scespedesa/Cutting-marble-machine/(list of files, cad)

Other CAD files:
Cableados_PackandGo/Tablero_Electrico_MotorHusillo/1.ipt
Cableados_PackandGo/Tablero_Electrico_MotorHusillo/2.ipt
Cableados_PackandGo/Tablero_Electrico_MotorHusillo/3.ipt
Cableados_PackandGo/Tablero_Electrico_MotorHusillo/4.ipt
Cableados_PackandGo/Tablero_Electrico_MotorHusillo/5.ipt
Cableados_PackandGo/Tablero_Electrico_MotorHusillo/6.ipt
Cableados_PackandGo/Tablero_Electrico_MotorHusillo/Bornera_Linea.iam
Cableados_PackandGo/Tablero_Electrico_MotorHusillo/Bornera_Tierra.iam
Cableados_PackandGo/Tablero_Electrico_MotorHusillo/Breaker.iam
Cableados_PackandGo/Tablero_Electrico_MotorHusillo/CLIP.ipt
Cableados_PackandGo/Tablero_Electrico_MotorHusillo/COQUE.ipt
Cableados_PackandGo/Tablero_Electrico_MotorHusillo/ECX1050.ipt
Cableados_PackandGo/Tablero_Electrico_MotorHusillo/GCX1231L OPERATOR.ipt
Cableados_PackandGo/Tablero_Electrico_MotorHusillo/GCX1232L OPERATOR.ipt
Cableados_PackandGo/Tablero_Electrico_MotorHusillo/GCX1234L OPERATOR.ipt
Cableados_PackandGo/Tablero_Electrico_MotorHusillo/GUARDAMOTOR_TUERCA.ipt
Cableados_PackandGo/Tablero_Electrico_MotorHusillo/LED_Rojo.iam
Cableados_PackandGo/Tablero_Electrico_MotorHusillo/LED_Verde.iam
Cableados_PackandGo/Tablero_Electrico_MotorHusillo/Led_Azul.iam
Cableados_PackandGo/Tablero_Electrico_MotorHusillo/MANETTE.ipt
Cableados_PackandGo/Tablero_Electrico_MotorHusillo/RTO_8-TC_BU-select.ipt
Cableados_PackandGo/Tablero_Electrico_MotorHusillo/Riel1.ipt
Cableados_PackandGo/Tablero_Electrico_MotorHusillo/Riel_Din_100.ipt
Cableados_PackandGo/Tablero_Electrico_MotorHusillo/Tablero_RocaHusillo.Harness1.iam
Cableados_PackandGo/Tablero_Electrico_MotorHusillo/Tablero_RocaHusillo.Harness1.ipt
Cableados_PackandGo/Tablero_Electrico_MotorHusillo/Temporizador.ipt
Cableados_PackandGo/Tablero_Electrico_MotorHusillo/UK_35-PE_N-select.ipt
Cableados_PackandGo/Tablero_Electrico_MotorHusillo/VIS_7D.ipt
Cableados_PackandGo/Tablero_Electrico_MotorHusillo/cajamotorhusilllo.idw
Cableados_PackandGo/Tablero_Electrico_MotorHusillo/contactor.ipt
Cableados_PackandGo/Tablero_Electrico_MotorHusillo/ecx1029.ipt
Cableados_PackandGo/Tablero_Electrico_MotorHusillo/reletermico.iam
PlanosTablerosElectricosyCajareductoratorque/Aumentador.ipn
PlanosTablerosElectricosyCajareductoratorque/PlanosTablerosElectricosyCajareductoratorque/Aumentador.ipn
