scespedesa/Cutting-marble-machine/PDF_PLANOS/DibujoMesaEnsamblada.pdf

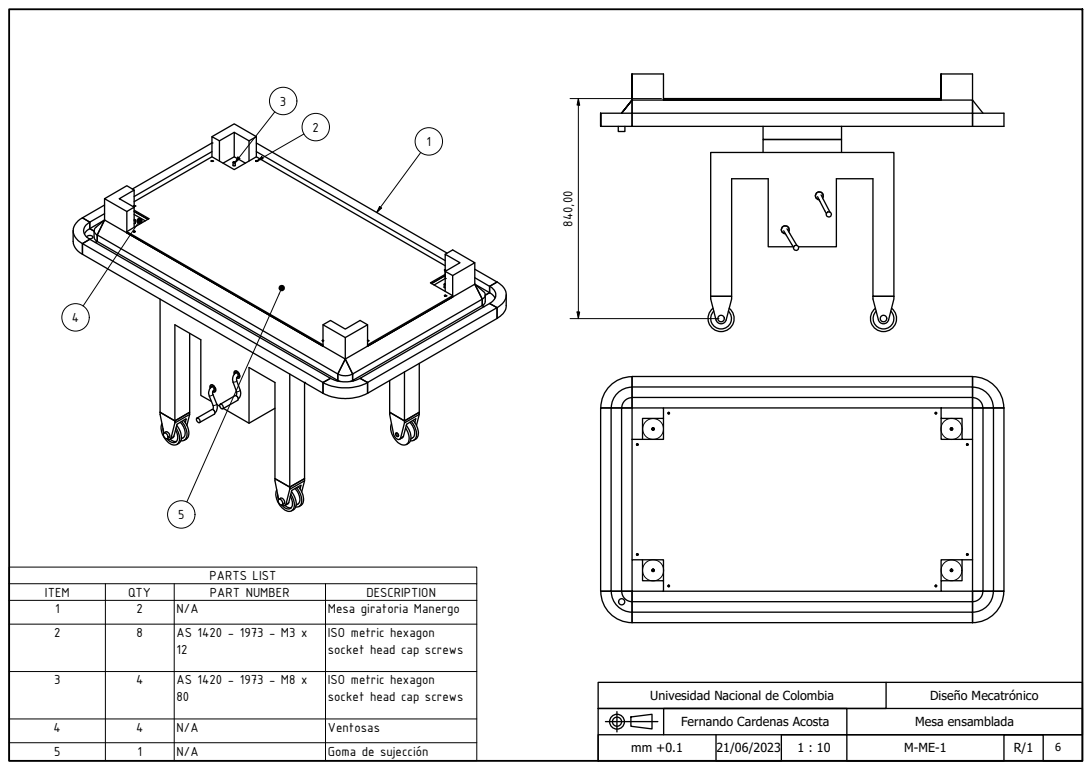
[picture p1: page 1]
PARTS LIST

ITEM | QTY | PART NUMBER | DESCRIPTION
1 | 2 | N/A | Mesa giratoria Manergo

2 | 8 | AS 1420 - 1973 - M3 x 12 | ISO metric hexagon socket head cap screws

3 | 4 | AS 1420 - 1973 - M8 x 80 | ISO metric hexagon socket head cap screws

Univesidad Nacional de Colombia | Diseño Mecatrónico

4 | 4 | N/A | Ventosas

Fernando Cardenas Acosta Mesa ensamblada

5 | 1 | N/A | Goma de sujección
