scespedesa/Cutting-marble-machine/PDF_PLANOS/Cabezal.pdf

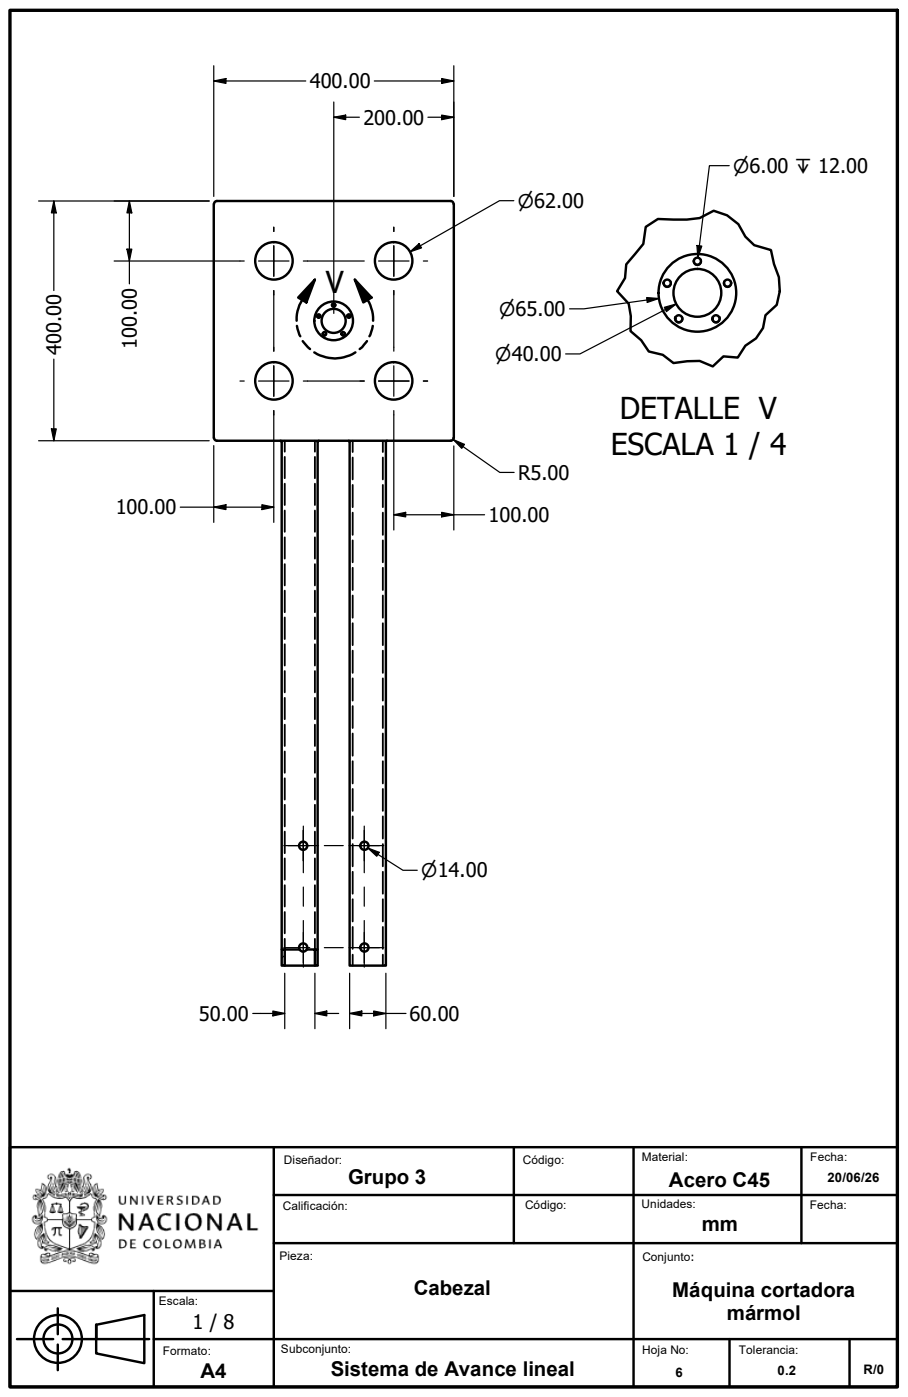
[picture p2: page 1]
DETALLE V ESCALA 1 / 4

Disexador: Grupo 3 | Cydigo: | Material: Acero C45 | Fecha: 20/06/26

Calificaciyn: | Cydigo: | Unidades: mm | Fecha:

Pieza: Cabezal | | Conjunto: Miquina cortadora mirmol

Escala: 1 / 8

Forma A4 | Subconjunto: to: Sistema de Avance lineal | Hoja No: 6 | Tolerancia: 0.2 | R/0
