scespedesa/Cutting-marble-machine/PDF_PLANOS/Copia de PlanoCajaReductorTorque.pdf

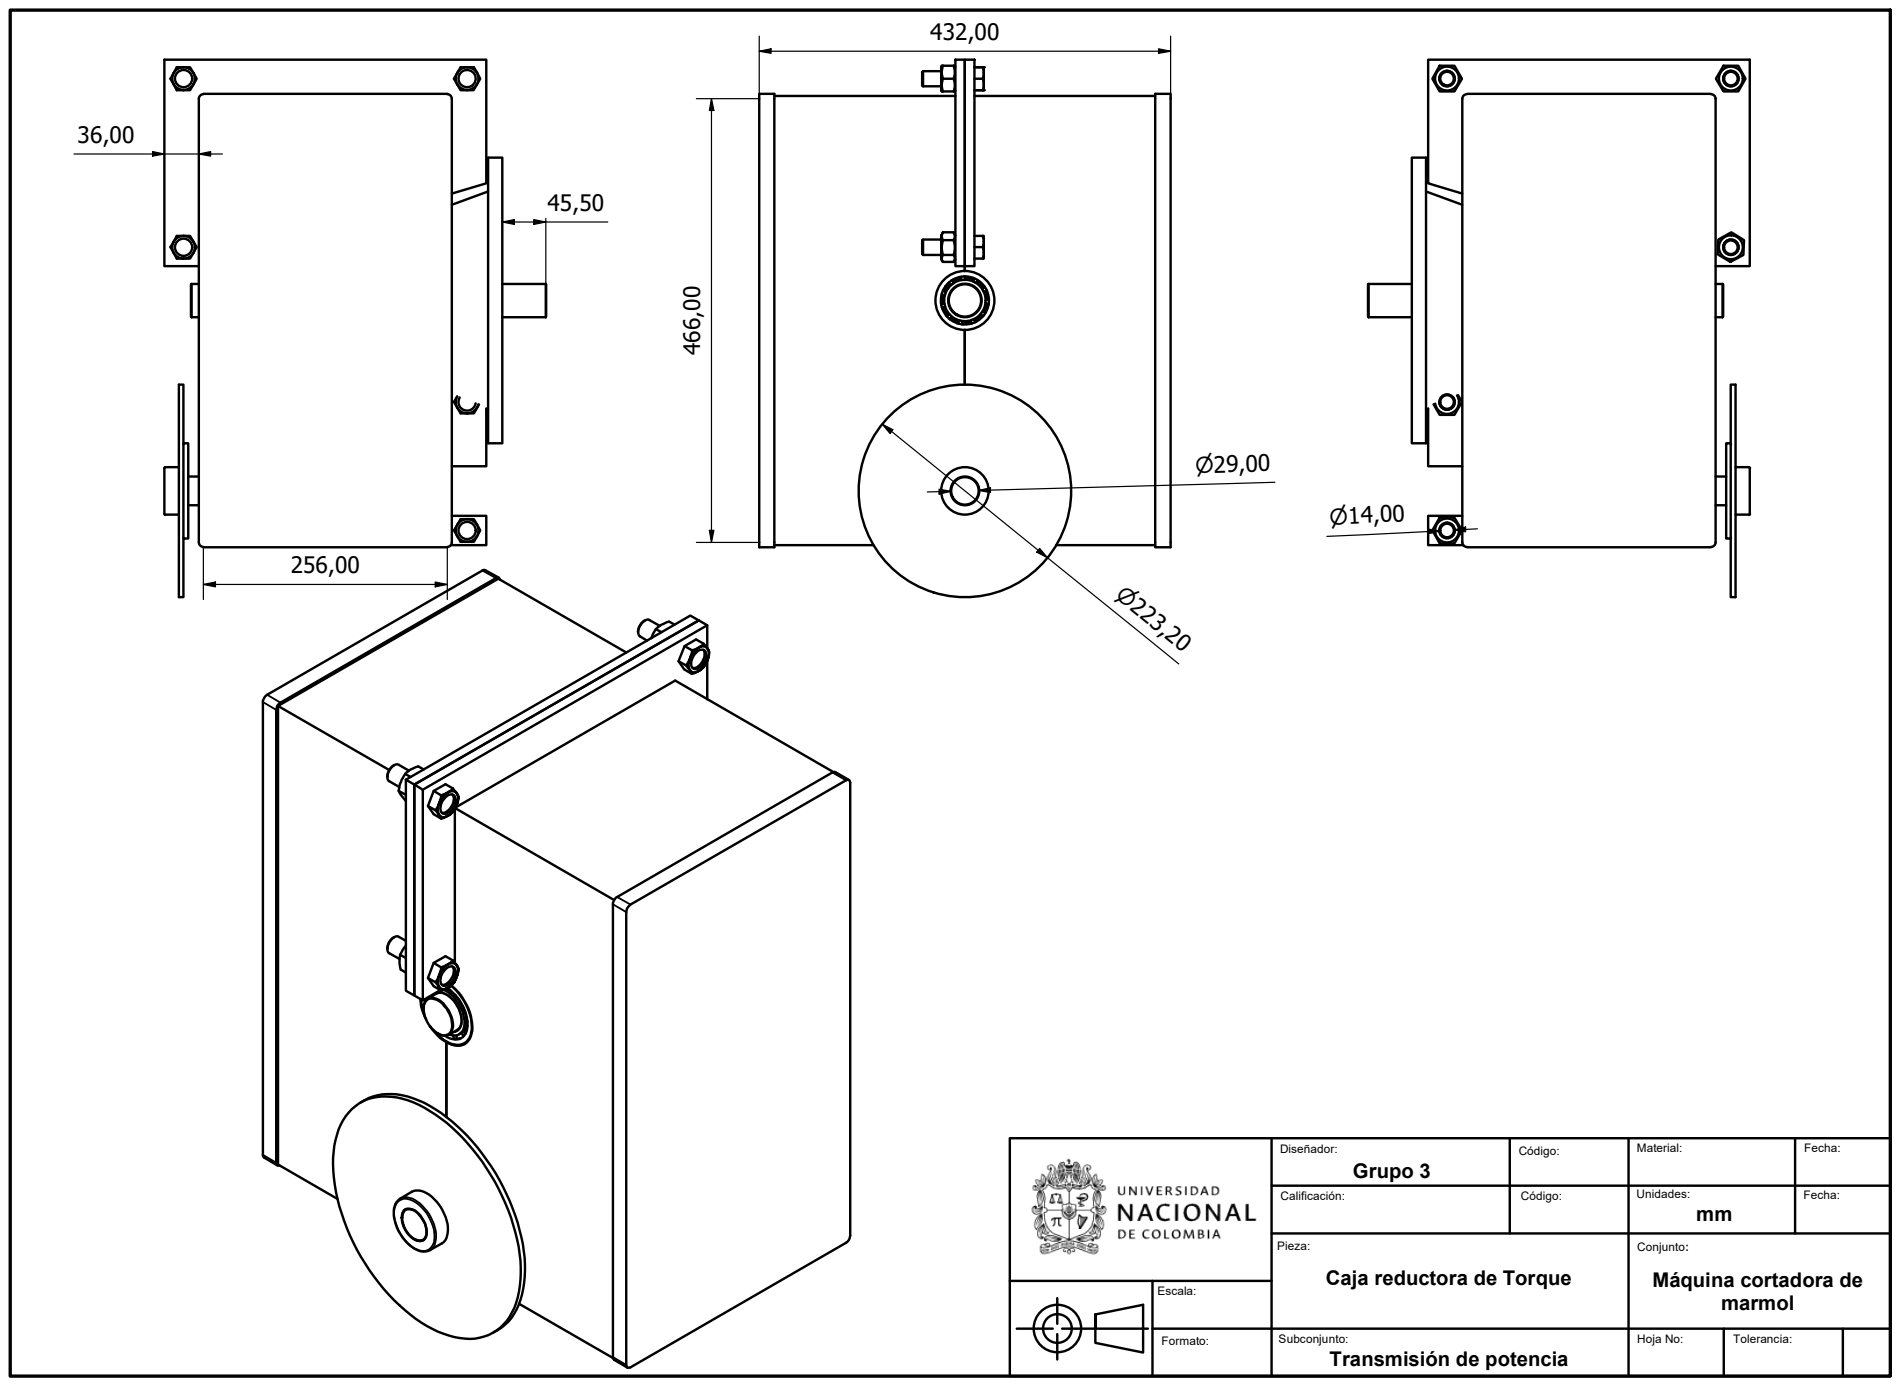
[picture p3: page 1]

Diseñador: Grupo 3 | Código: | Material: | Fecha:

Calificación: | Código: | Unidades: mm | Fecha:

Pieza: Caja reductora de Torque | | Conjunto: Máquina cortadora de marmol

Escala:

Forma | Subconjunto: to: Transmisión de potencia | Hoja No: | Tolerancia:
