scespedesa/Cutting-marble-machine/PDF_PLANOS/Parales.pdf

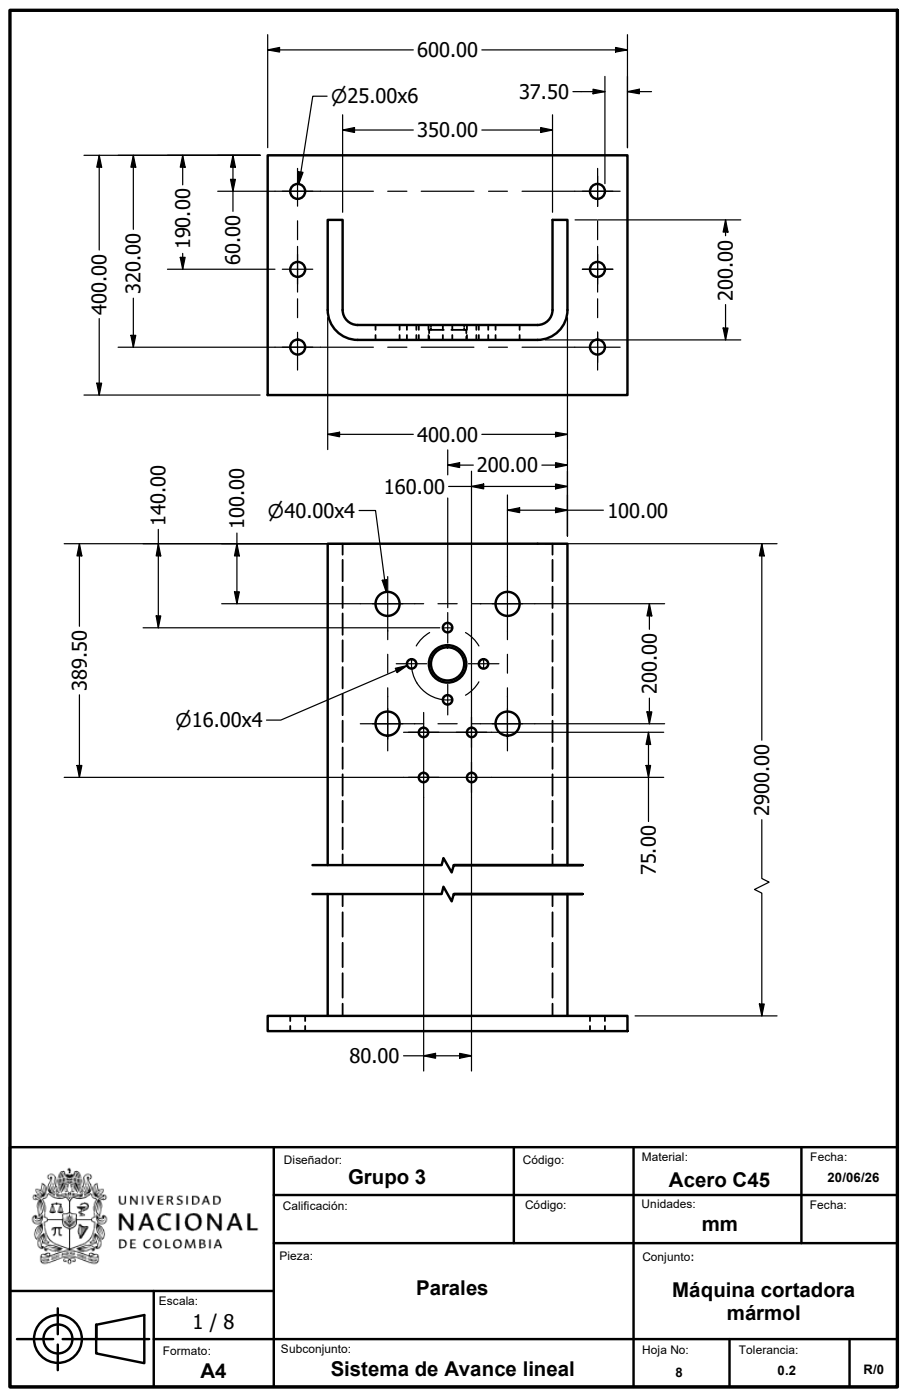
[picture p4: page 1]

Disexador: Grupo 3 | Cydigo: | Material: Acero C45 | Fecha: 20/06/26

Calificaciyn: | Cydigo: | Unidades: mm | Fecha:

Pieza: Parales | | Conjunto: Miquina cortadora mirmol

Escala: 1 / 8

Forma A4 | Subconjunto: to: Sistema de Avance lineal | Hoja No: 8 | Tolerancia: 0.2 | R/0
