scespedesa/Cutting-marble-machine/PDF_PLANOS/Plano_Eje_Proyecto_Final.pdf

40.00

60.00 | 100.00 | 100.00

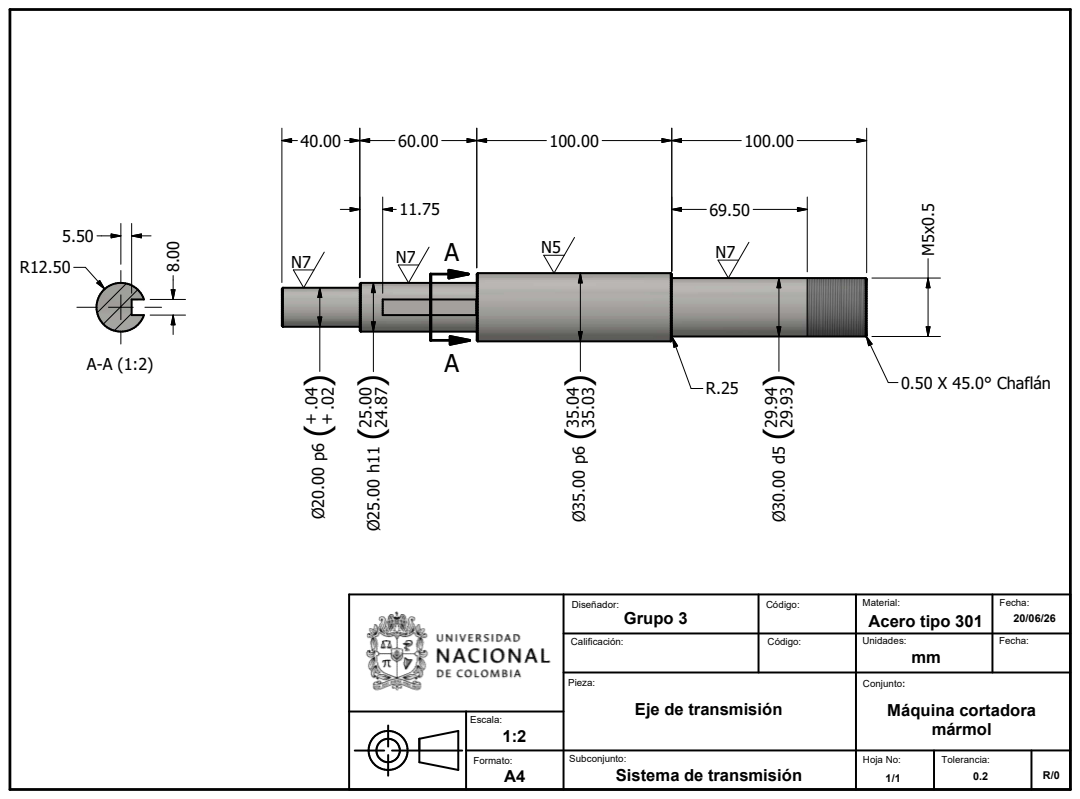
[picture p5: page 1]
M⁵x0.5; 0.50 X 45.0° Chaflán

Diseñador: Grupo 3 | Código: | Material: Acero tipo 301 | Fecha: 20/06/26

Calificación: | Código: | Unidades: mm | Fecha:

Pieza: Eje de transmisión | | Conjunto: Máquina cortadora mármol

Escala: 1:2

Formato: A4 | Subconjunto: Sistema de transmisión | Hoja No: 1/1 | Tolerancia: 0.2 | R/0
