scespedesa/Cutting-marble-machine/PDF_PLANOS/Soporte Motor.pdf

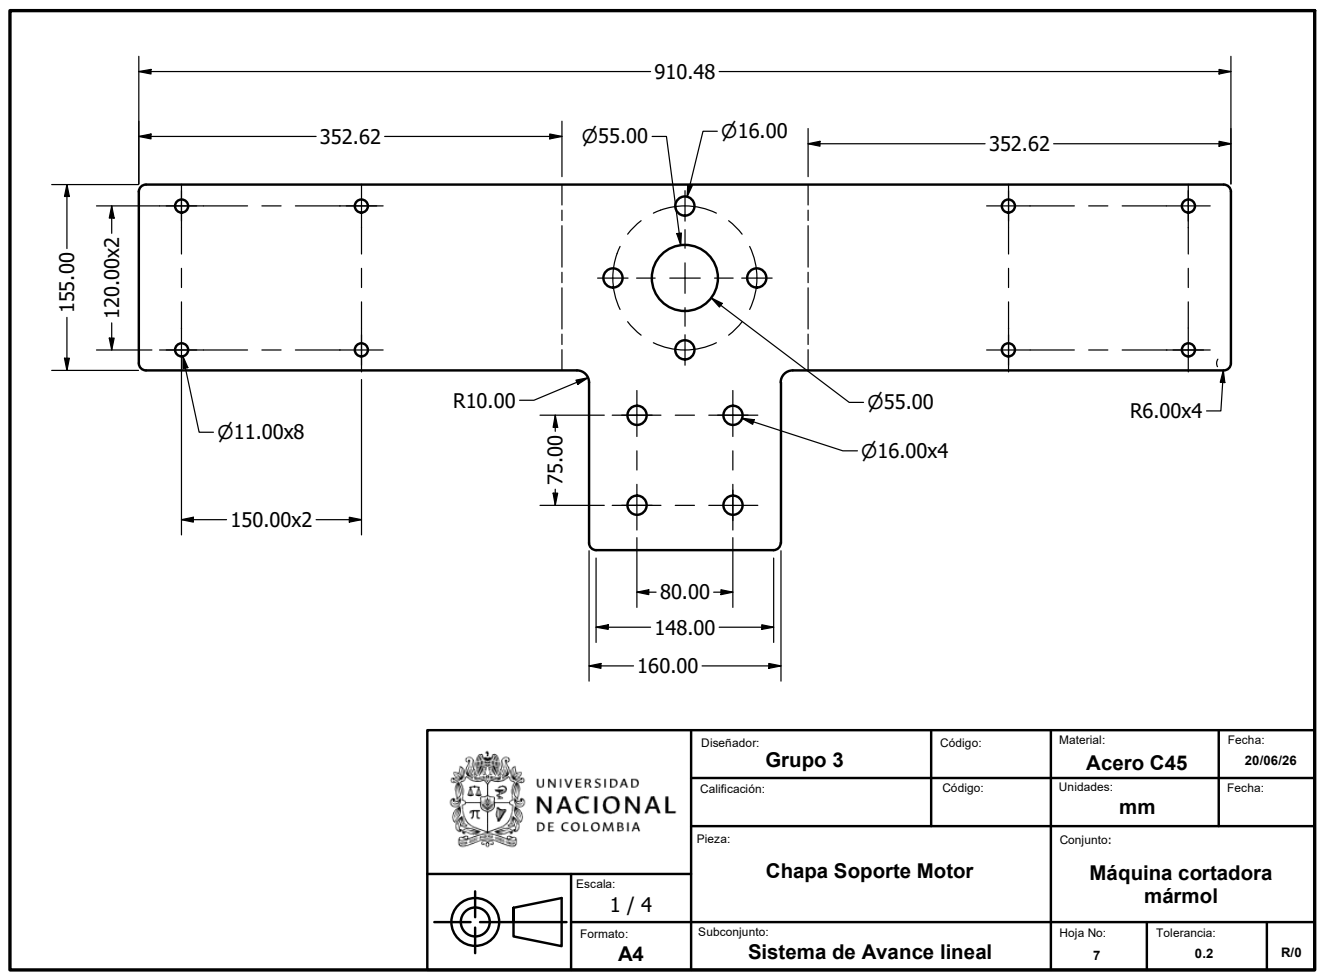
[picture p6: page 1]

Disexador: Grupo 3 | Cydigo: | Material: Acero C45 | Fecha: 20/06/26

Calificaciyn: | Cydigo: | Unidades: mm | Fecha:

Pieza: Chapa Soporte Motor | | Conjunto: Miquina cortadora mirmol

Escala: 1 / 4

Forma A4 | Subconjunto: to: Sistema de Avance lineal | Hoja No: 7 | Tolerancia: 0.2 | R/0
