scespedesa/Cutting-marble-machine/PDF_PLANOS/Tornillo de potencia.pdf

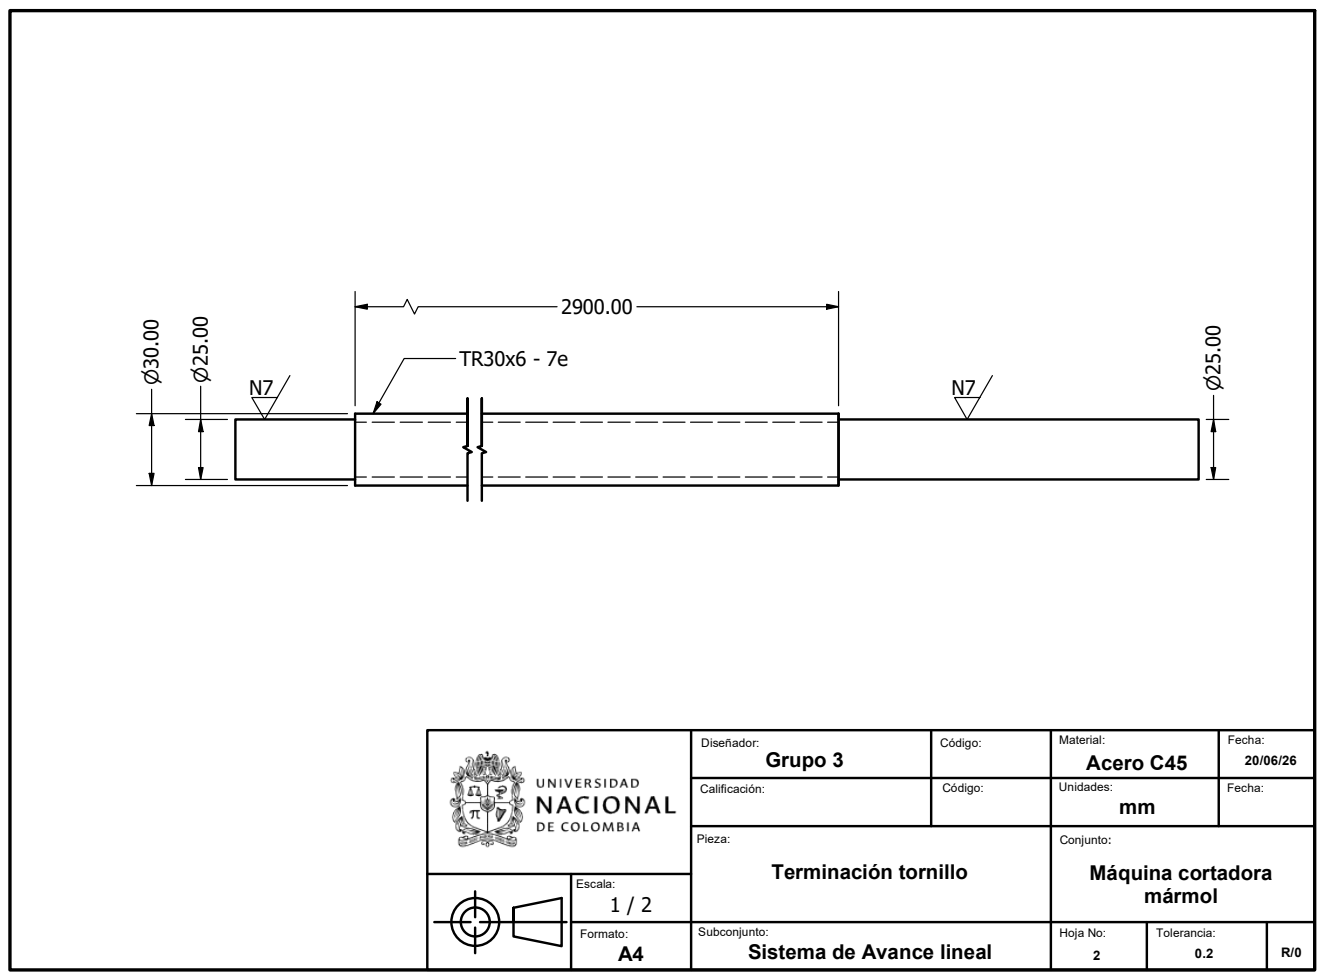
[picture p7: page 1]

Disexador: Grupo 3 | Cydigo: | Material: Acero C45 | Fecha: 20/06/26

Calificaciyn: | Cydigo: | Unidades: mm | Fecha:

Pieza: Terminaciyn tornillo | | Conjunto: Miquina cortadora mirmol

Escala: 1 / 2

Forma A4 | Subconjunto: to: Sistema de Avance lineal | Hoja No: 2 | Tolerancia: 0.2 | R/0
