scespedesa/Cutting-marble-machine/Cableados_PackandGo/Tablero_Electrico_MotorHusillo/cajamotorhusilllo.pdf

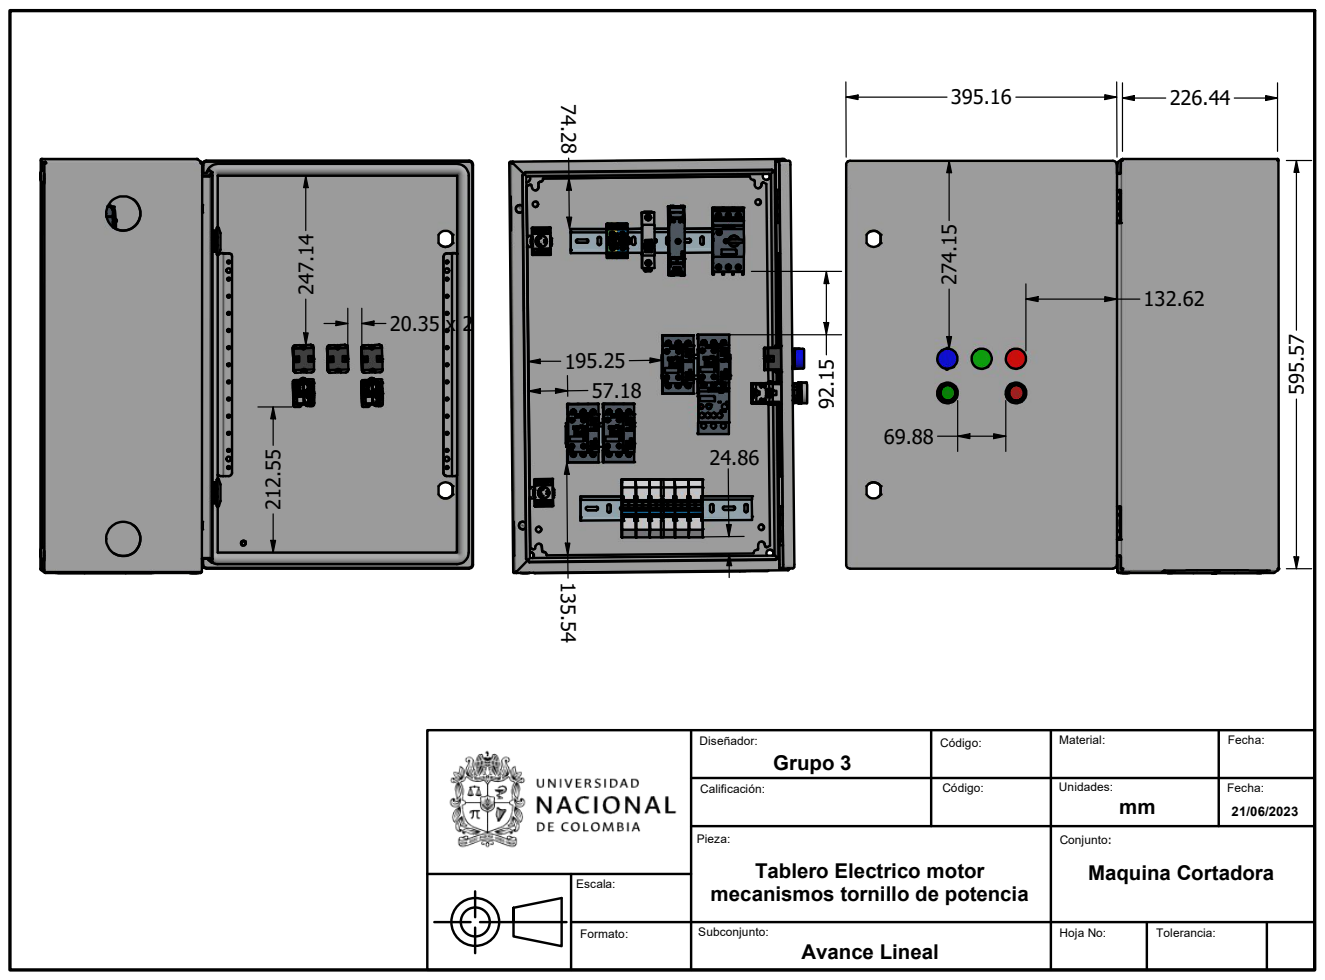
[picture p8: page 1]
Hoja No:; Forma; Subconjunto: to:; Maquina Cortadora; Avance Lineal; Grupo 3

Tablero Electrico motor
mecanismos tornillo de potencia
