scespedesa/Cutting-marble-machine/PDF_PLANOS/Copia de PlanoCaja_presentacion.pdf

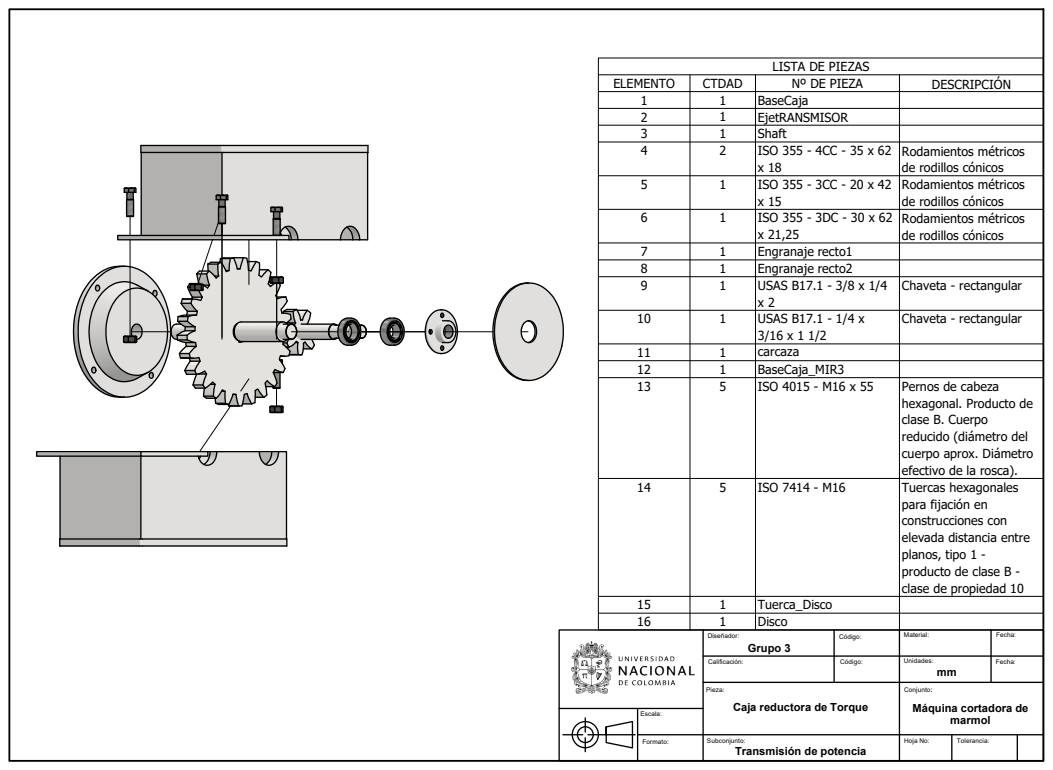
[picture p9: page 1]

LISTA DE PIEZAS

ELEMENTO | CTDAD | Nº DE PIEZA | DESCRIPCIÓN
1 | 1 | BaseCaja
2 | 1 | EjetRANSMISOR
3 | 1 | Shaft
4 | 2 | ISO 355 - 4CC - 35 x 62 x 18 | Rodamientos métricos de rodillos cónicos

5 | 1 | ISO 355 - 3CC - 20 x 42 x 15 | Rodamientos métricos de rodillos cónicos

6 | 1 | ISO 355 - 3DC - 30 x 62 x 21,25 | Rodamientos métricos de rodillos cónicos

7 | 1 | Engranaje recto1
8 | 1 | Engranaje recto2
9 | 1 | USAS B17.1 - 3/8 x 1/4 x 2 | Chaveta - rectangular

10 | 1 | USAS B17.1 - 1/4 x 3/16 x 1 1/2 | Chaveta - rectangular

11 | 1 | carcaza
12 | 1 | BaseCaja_MIR3
13 | 5 | ISO 4015 - M16 x 55 | Pernos de cabeza hexagonal. Producto de clase B. Cuerpo reducido (diámetro del cuerpo aprox. Diámetro efectivo de la rosca).

14 | 5 | ISO 7414 - M16 | Tuercas hexagonales para fijación en construcciones con elevada distancia entre planos, tipo 1 -producto de clase B -clase de propiedad 10

15 | 1 | Tuerca_Disco
16 | 1 | Disco

Diseñador: Grupo 3 | Código: | Material: | Fecha:

Calificación: | Código: | Unidades: mm | Fecha:

Pieza: Caja reductora de Torque | | Conjunto: Máquina cortadora de marmol

Escala:

Forma | Subconjunto: to: Transmisión de potencia | Hoja No: | Tolerancia:
