scespedesa/Cutting-marble-machine/PDF_PLANOS/DibujoGoma.pdf

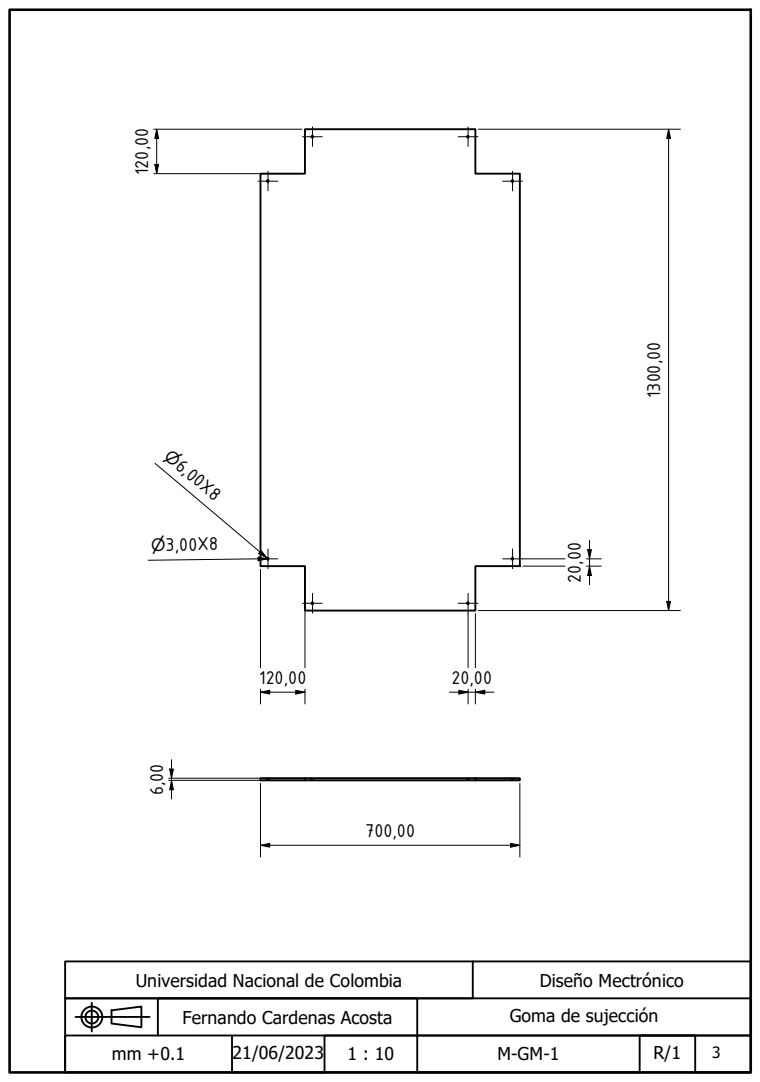
[picture p10: page 1]

Universidad Nacional de Colombia | Diseño Mectrónico

Fernando Cardenas Acosta Goma de sujección
