scespedesa/Cutting-marble-machine/PDF_PLANOS/DibujoMesa.pdf

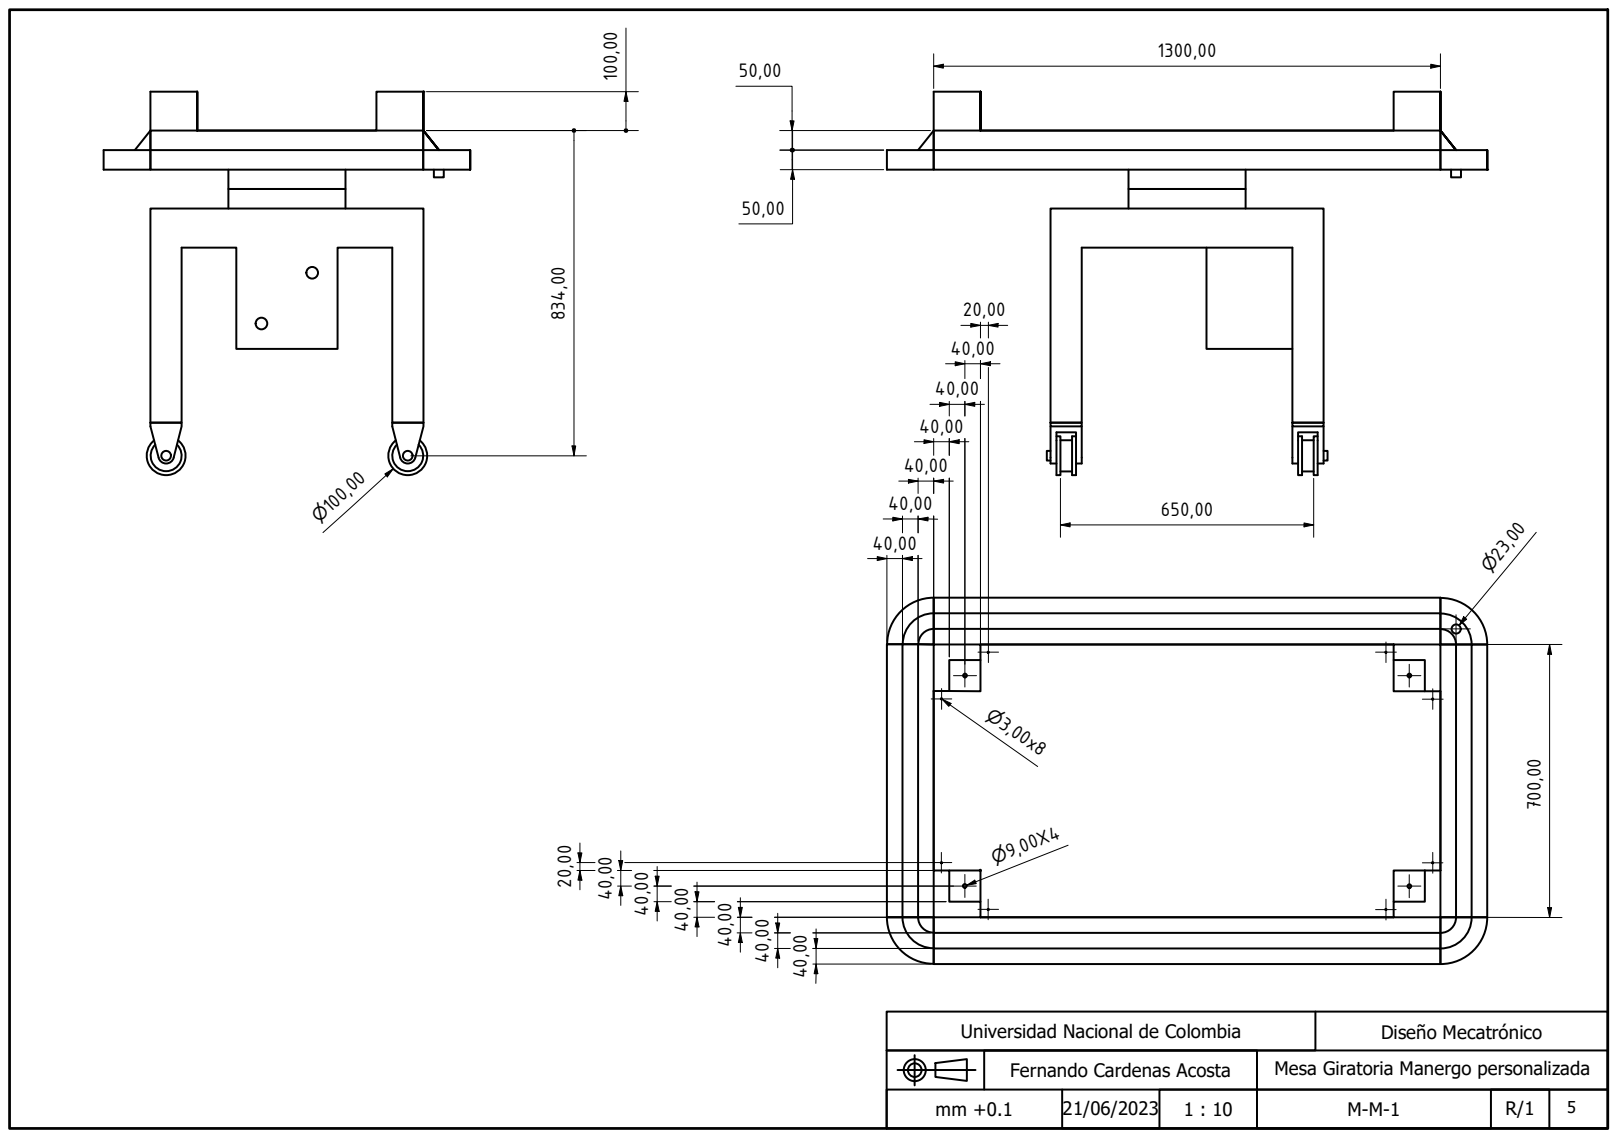
[picture p11: page 1]

Universidad Nacional de Colombia | Diseño Mecatrónico

Fernando Cardenas Acosta Mesa Giratoria Manergo personalizada
